dariogreggio/PC_PIC/README.md

# PC_PIC
a full computer made with Microchip PICs, featuring *everything*
