dariogreggio/PC_PIC/(notices)

Notices in the files:
PC_PIC.brd:
(C) 2021
parts and their libraries:
microbuilder: This work is placed in the public domain, and may be freely used for commercial and non-commercial work with the following conditions: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
wurth_electronics_midcom_inc_v1-0: Copyright: Wurth Electronics Midcom, Inc.
